Gori369/wireless-stearing-button-box-/README.md

# wireless-stearing-button-box-
DIY wireless sim racing button box using an ESP32-WROOM-32 with Bluetooth PC connectivity. Features 8 push buttons, 4 potentiometers, 2 toggle switches, and an internal battery. Includes a custom 3D-printed body and rear quick-release mount. Works as a gamepad for customizable controls in compatible PC games and racing simulators.
