Gori369/wireless-stearing-button-box-/pictures and video/Screenshot 2026-10-28 011944.png

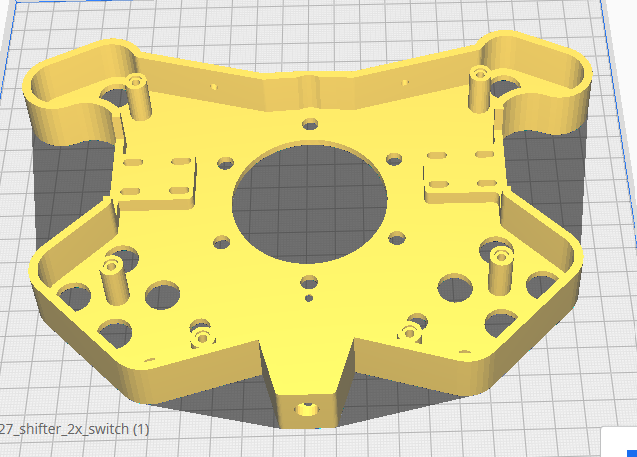
pictures and video/Screenshot 2026-10-28 011944.png
