Gori369/wireless-stearing-button-box-/pictures and video/WhatsApp Image 2026-10-28 at 12.40.40 AM (1).jpeg

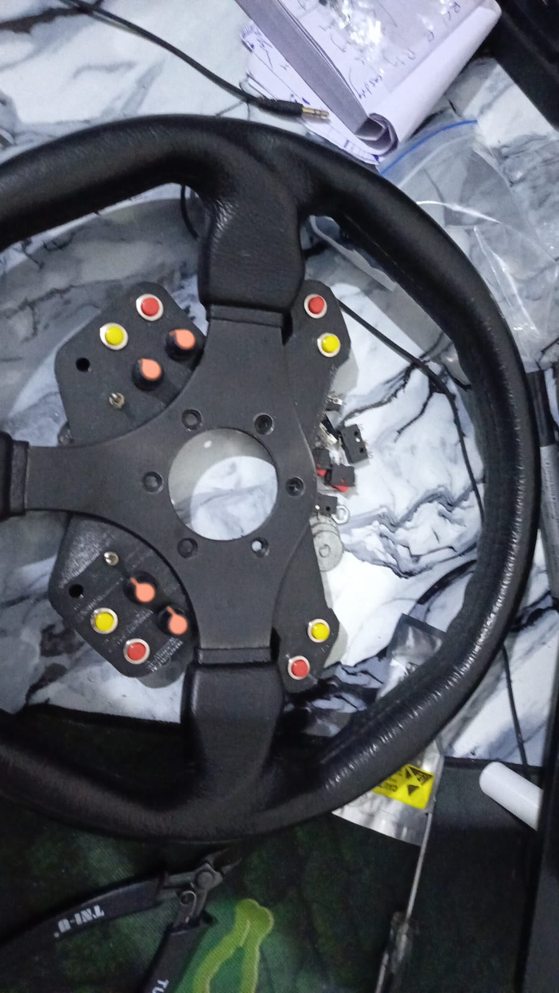
pictures and video/WhatsApp Image 2026-10-28 at 12.40.40 AM (1).jpeg
