Gori369/wireless-stearing-button-box-/Firmware/button_plate_rev_1.stl

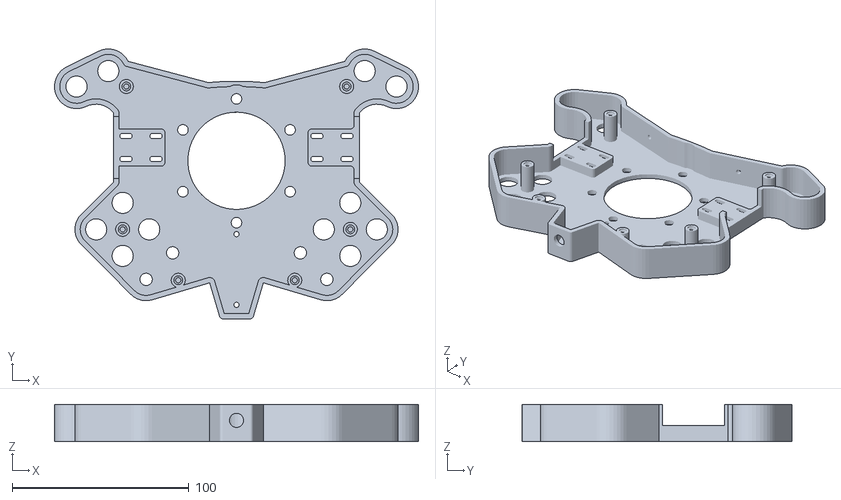
[picture p16: CAD file, 2026-10-25]
Firmware/button_plate_rev_1.stl
205.9 x 152.7 x 21.0
