Gori369/wireless-stearing-button-box-/Firmware/dankart27_paddle.STL

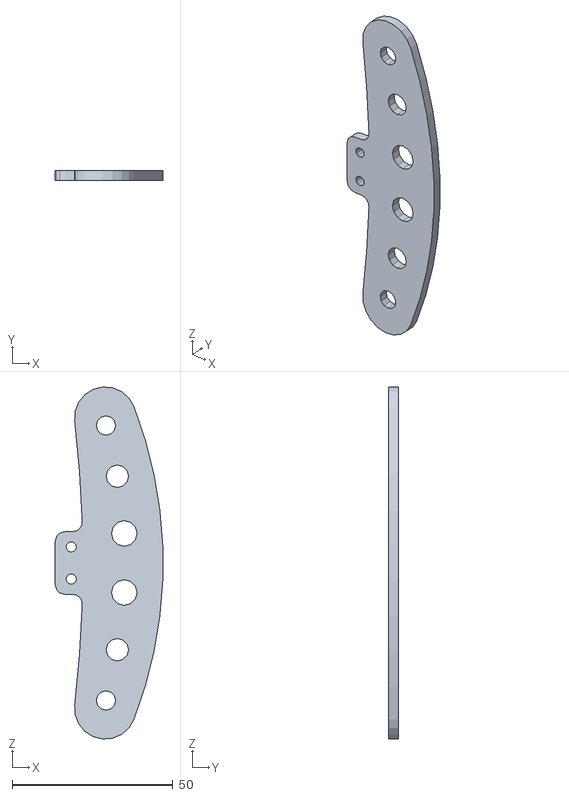
[picture p17: CAD file, 2026-10-25]
Firmware/dankart27_paddle.STL
33.5 x 3.00 x 109.6
