Gori369/wireless-stearing-button-box-/Firmware/dankart27_paddle_hinge.STL

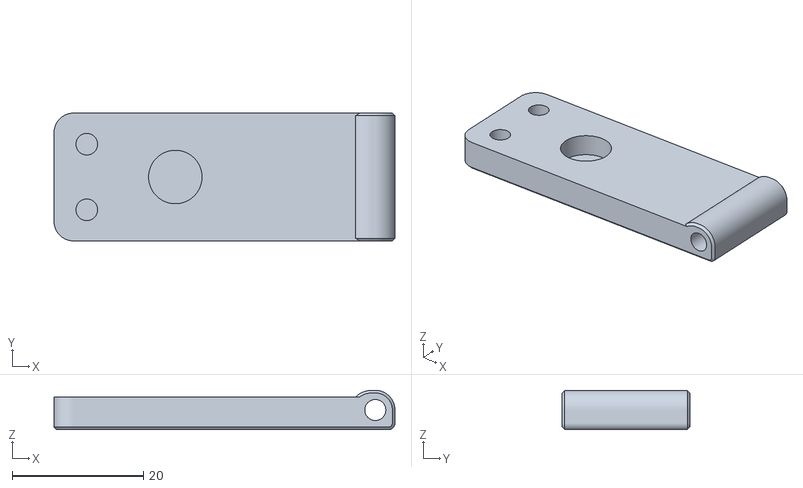
[picture p18: CAD file, 2026-10-25]
Firmware/dankart27_paddle_hinge.STL
52.0 x 19.5 x 6.00
