Gori369/wireless-stearing-button-box-/Firmware/horn_plate_thin_rev1.stl

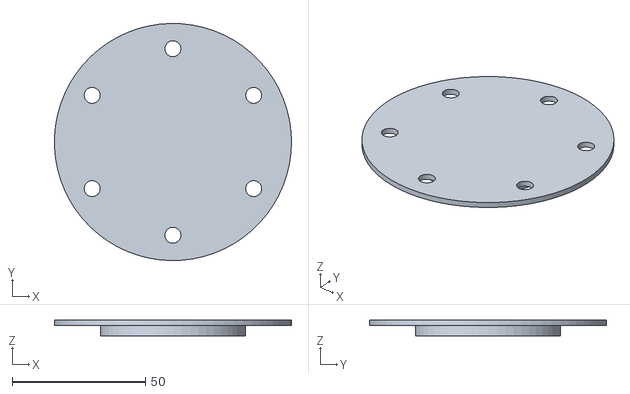
[picture p19: CAD file, 2026-10-25]
Firmware/horn_plate_thin_rev1.stl
89.0 x 89.0 x 6.00
