Gori369/wireless-stearing-button-box-/Firmware/dankart27_paddle_offset.STL

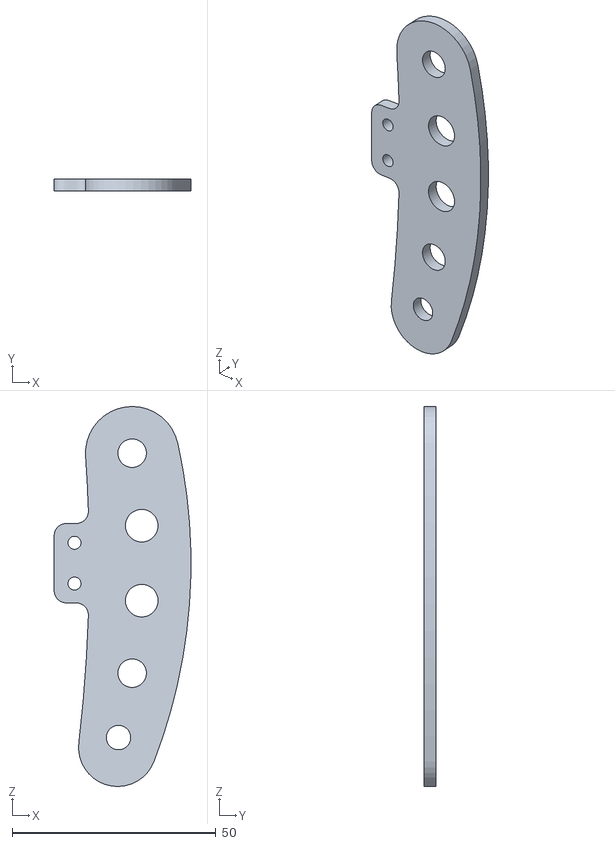
[picture p20: CAD file, 2026-10-25]
Firmware/dankart27_paddle_offset.STL
33.6 x 3.00 x 93.3
