Gori369/wireless-stearing-button-box-/Firmware/dankart27_shifter_2x_switch (1).stl

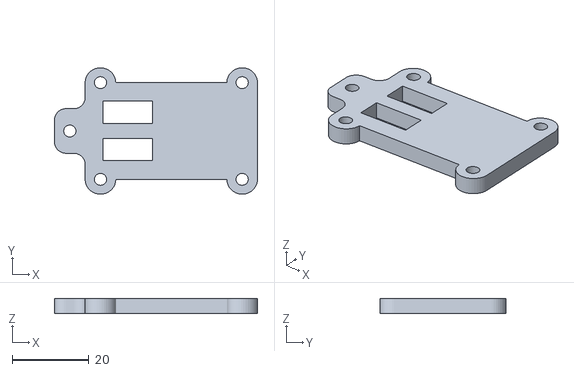
[picture p21: CAD file, 2026-10-25]
Firmware/dankart27_shifter_2x_switch (1).stl
53.0 x 33.0 x 4.00
