Gori369/wireless-stearing-button-box-/Firmware/button_plate_lid_rev1.stl

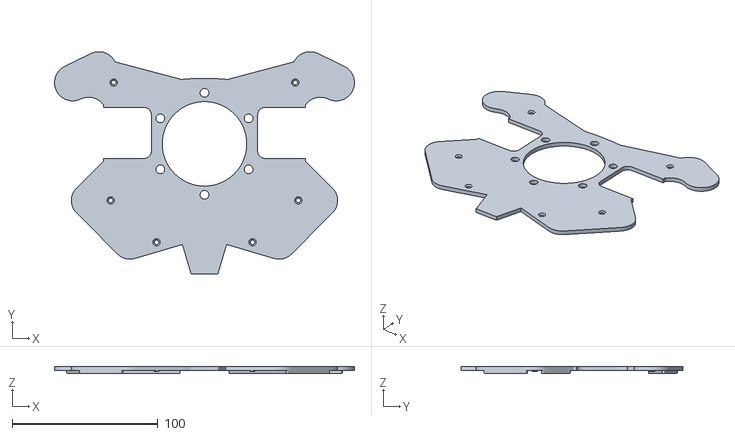
[picture p22: CAD file, 2026-10-25]
Firmware/button_plate_lid_rev1.stl
205.9 x 152.7 x 5.00
