Gori369/wireless-stearing-button-box-/Firmware/adapter_ring_rev1.stl

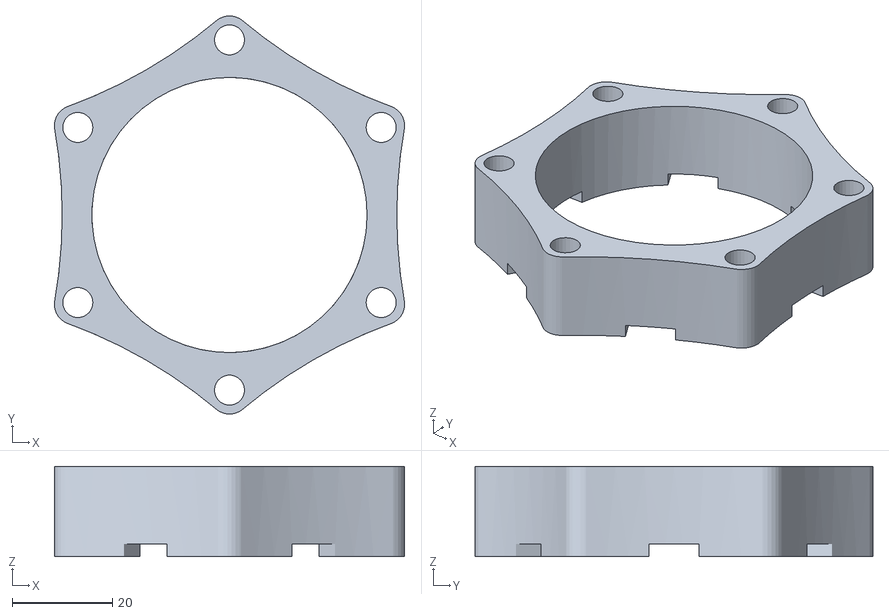
[picture p23: CAD file, 2026-10-25]
Firmware/adapter_ring_rev1.stl
70.0 x 79.5 x 18.0
