Gori369/wireless-stearing-button-box-/pictures and video/steering_button_box_wiring_simple_edited.pdf

# STEERING BUTTON BOX

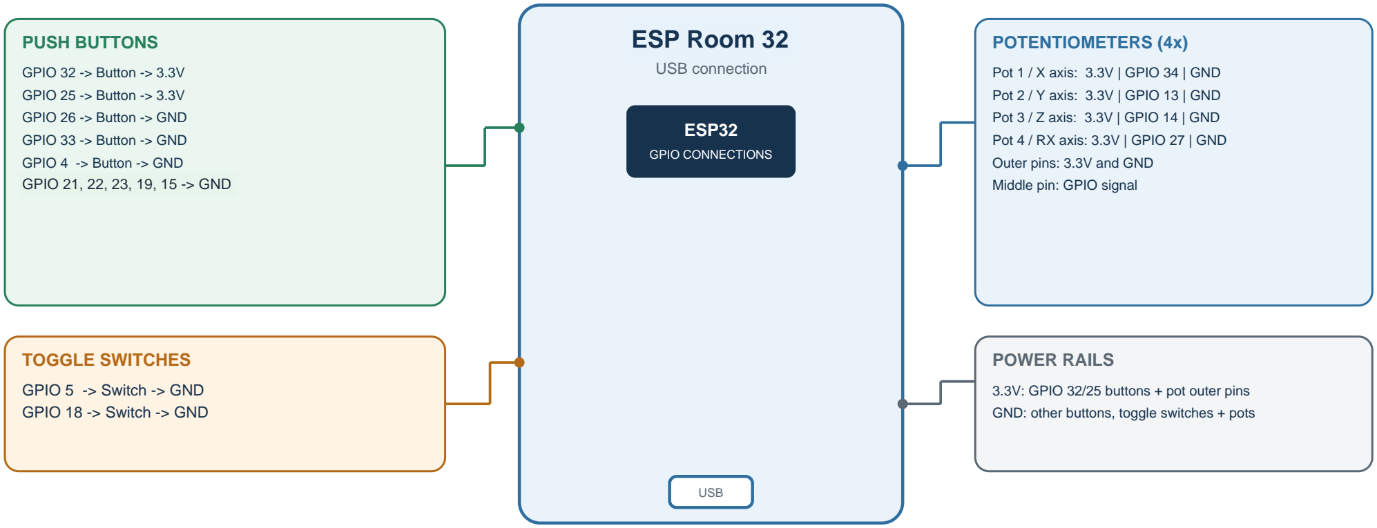
[picture p24: figure]
ESP32; GPIO CONNECTIONS; USB; PUSH BUTTONS; GPIO 32 -> Button -> 3.3V GPIO 25 -> Button -> 3.3V GPIO 26 -> Button -> GND GPIO 33 -> Button -> GND GPIO 4 -> Button -> GND; TOGGLE SWITCHES; GPIO 5 -> Switch -> GND GPIO 18 -> Switch -> GND; POTENTIOMETERS (4x); Pot 1 / X axis: 3.3V | GPIO 34 | GND Pot 2 / Y axis: 3.3V | GPIO 13 | GND Pot 3 / Z axis: 3.3V | GPIO 14 | GND Pot 4 / RX axis: 3.3V | GPIO 27 | GND Outer pins: 3.3V and GND Middle pin: GPIO signal; POWER RAILS; ESP Room 32; USB connection; GPIO 21, 22, 23, 19, 15 -> GND

3.3V: GPIO 32/25 buttons + pot outer pins GND: other buttons, toggle switches + pots

Use 3.3V logic only. Never connect 5V directly to ESP32 GPIO pins.

### ESP Room 32 | Simple Wiring Guide

### Contact: +92 345 9714998
