Gori369/wireless-stearing-button-box-/(commit log)

2026-10-25 Create 3d printed parts stl
2026-10-25 Create 3d files stl
2026-10-25 Create circuit diagram
2026-10-25 Create assembly guide
2026-10-25 Update assembly guide
2026-10-28 Refactor Arduino gamepad code and update comments
2026-10-28 Create stl files
2026-10-28 Create 3d stl files link
2026-10-28 Update 3d stl files link
